philippedc/Arduino-Uno-HDD-Nipkow-disc-clock/Arduino Uno Nipkow dick clock.pdf

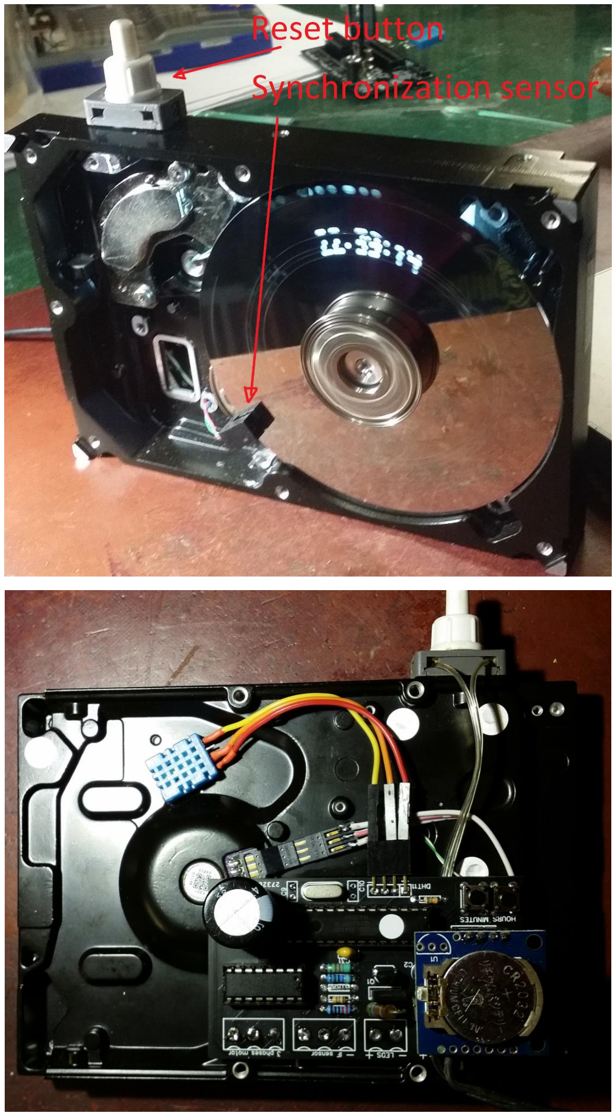
[picture p5: page 16]
